lisberg/Inky-Impression-Weather-Station/enclosure/out/stand.step

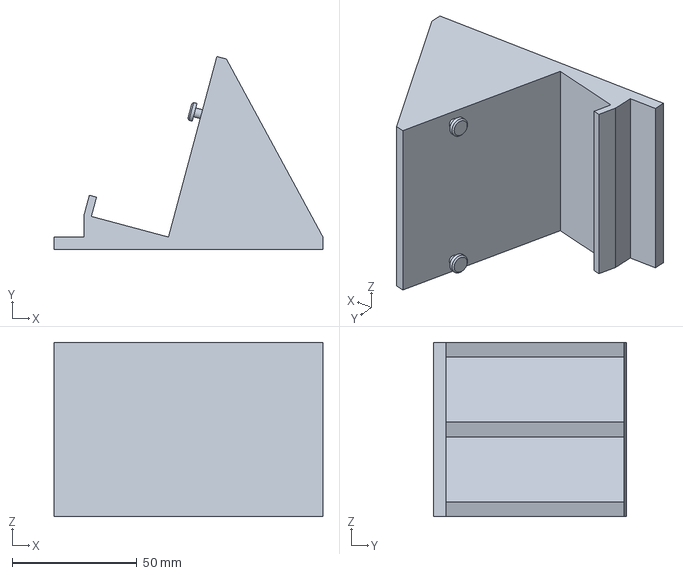
[picture p11: CAD file, 2026-11-04]
enclosure/out/stand.step
107.9 x 77.4 x 70.0 mm
