lisberg/Inky-Impression-Weather-Station/enclosure/out/back.step

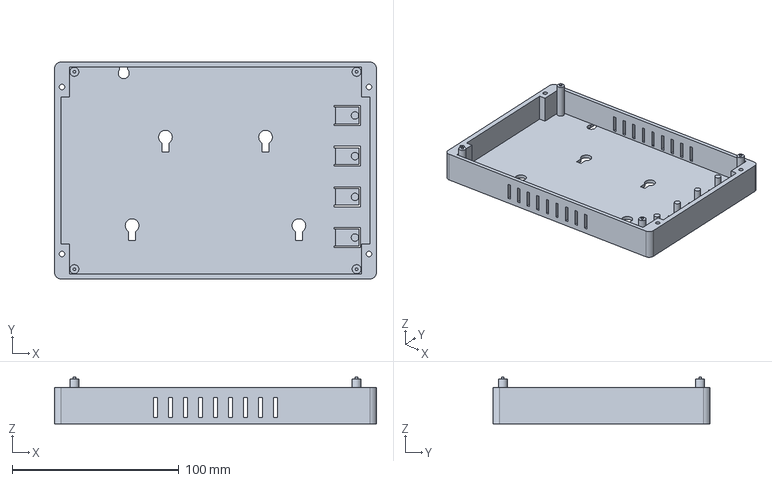
[picture p12: CAD file, 2026-11-04]
enclosure/out/back.step
193.0 x 130.1 x 28.2 mm
