lisberg/Inky-Impression-Weather-Station/enclosure/out/bezel.step

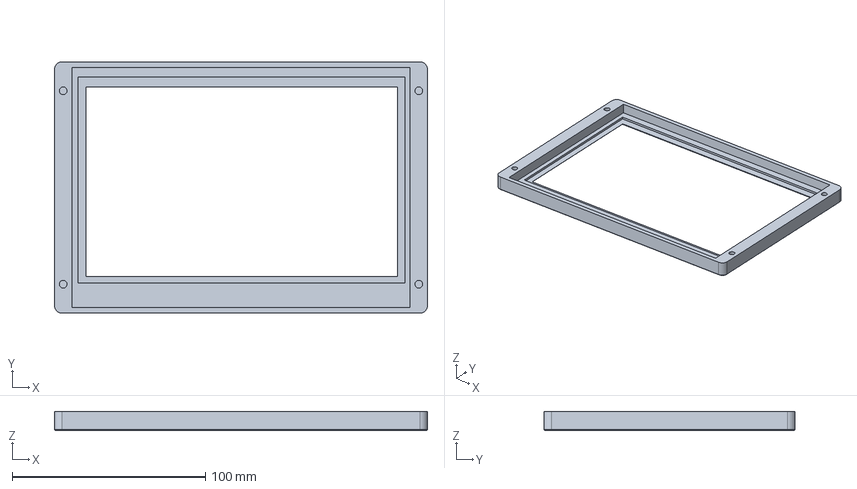
[picture p13: CAD file, 2026-11-04]
enclosure/out/bezel.step
193.0 x 130.1 x 10.0 mm
