lisberg/Inky-Impression-Weather-Station/enclosure/out/cable_hook.step

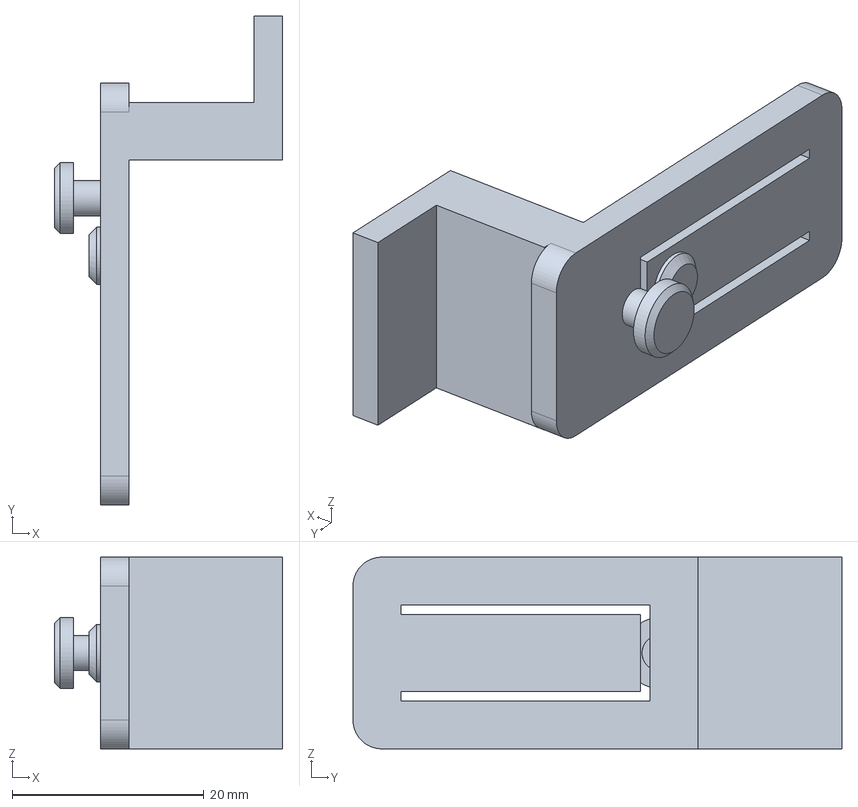
[picture p14: CAD file, 2026-11-04]
enclosure/out/cable_hook.step
23.8 x 51.0 x 20.0 mm
