lisberg/Inky-Impression-Weather-Station/(list of files, cad)

Other CAD files:
enclosure/out/back.3mf
enclosure/out/bezel.3mf
enclosure/out/cable_hook.3mf
enclosure/out/stand.3mf
