lisberg/Inky-Impression-Weather-Station/(commit log)

2026-10-19 Rework station: config file, Yr/SMHI providers, 800x480 layouts, night theme
    Replaces the OpenWeather scripts with a station package: JSON config with
    multiple locations, Yr and SMHI forecast providers with cached fetches,
    local sunrise/sunset, overview and week layouts for the 7.3" panel, and a
    night theme. Icons now come from the Weather Icons font so they scale and
    recolour cleanly.
    Claude-Session: https://claude.ai/code/session_01PSGzCCsaaUTuFZMPxqBwve
    [app.py, config.py, display.py, i18n.py, models.py]
2026-10-19 Buttons, info screen, WiFi fallback hotspot and deploy scripts
    A/B cycle locations, C cycles layout, D refreshes, holding D shows an info
    screen with WiFi, IP and Tailscale details. A netwatch service opens a setup
    hotspot when no saved network is reachable, and the screen shows how to join
    it. deploy/ holds an idempotent installer, Tailscale join, WiFi pre-loading
    and update scripts.
    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
2026-10-19 Fix setup hotspot URL constant; add pytest workflow
    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
    [netwatch.py]
2026-10-19 Parametric enclosure: bezel, back shell with flexure buttons, desk stand
    CadQuery model for the Inky Impression 7.3" with a Pi Zero 2 W behind it.
    The back shell clamps the board into the bezel, has flexure buttons over
    the board's rear buttons, keyholes for wall hanging and for the stand, vents
    and a USB slot. The script checks for collisions against a dummy board
    and on the stand before exporting STEP and 3MF.
    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
    [back.3mf, back.step, bezel.3mf, bezel.step, stand.3mf, stand.step]
2026-10-25 Run buttons on lgpio with a writable LG_WD; don't crash if GPIO fails
    gpiozero fell back to the sysfs pin factory (EINVAL on export) because lgpio
    could not create its notification pipes in the root-owned working directory.
    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
    [buttons.py]
2026-10-27 Dashboard redesign: card layout, tab bar on phones, light/dark theme, htmx
    - htmx (vendored, works offline on the setup hotspot) boosts every form, so
    changes save without full page reloads; everything still works without JS
    - the live panel preview leads the page, with quick place switching
    - segmented controls for layout and night mode; bottom tab bar on phones
    - System tab with status tiles and the station's recent log events
    - light and dark themes follow the system, with a toggle that overrides it
    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
    [app.py, web.py]
2026-11-02 Enclosure: use Linus's measured board and glass dimensions
    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
    [back.3mf, back.step, bezel.3mf, bezel.step, stand.3mf, stand.step]
2026-11-02 Enclosure: measured glass width and button spacing
    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
    [back.3mf, back.step, bezel.3mf, bezel.step, stand.3mf, stand.step]
2026-11-02 Enclosure: buttons 3.5 mm from the board edge; keep their tabs inside the pocket
    The tab slides inwards so its slot clears the side wall; the plunger stays
    over the switch, near the tab's free end. The fit check now fails if the
    plunger would fall off its tab.
    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
    [back.3mf, back.step, bezel.3mf, bezel.step, stand.3mf, stand.step]
2026-11-03 Enclosure: all board measurements in; fix front/back mirroring
    Adds the measured image area, corner holes (2.5 in, 2.0 mm), button height
    (5.4), Pi height (20) and the Pi's USB socket position, and trims the corner
    posts so they stay clear of the bezel wall.
    The model's +X points right seen from the back, but the glass, image-area
    and USB offsets were applied as if it pointed right seen from the front.
    Offsets given seen from the front are now mirrored into the model, and the
    buttons, given seen from the back, are used as they are.
    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
    [back.3mf, back.step, bezel.3mf, bezel.step, stand.3mf, stand.step]
2026-11-04 Enclosure: cable leaves through a notch in the back plate, clear of the stand
    The bottom-wall slot sat right on the stand's ledge, so the cable had
    nowhere to go on a desk. A keyhole notch at the back plate's bottom edge,
    55 mm off centre, lets it run straight out behind; the check now fails if
    the exit would end up behind the stand.
    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
    [back.3mf, back.step, bezel.3mf, bezel.step, stand.3mf, stand.step]
2026-11-04 Enclosure: larger cable notch (6.5 mm hole, 4.8 mm neck)
    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
    [back.3mf, back.step, bezel.3mf, bezel.step, stand.3mf, stand.step]
2026-11-04 Stand: cable winder posts behind the station
    The base runs on 32 mm past the ribs and carries two mushroom posts for
    winding up spare USB cable; a cone under each cap prints without supports.
    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
    [back.3mf, back.step, bezel.3mf, bezel.step, stand.3mf, stand.step]
2026-11-04 Enclosure: clip-in cable hooks for the wall keyholes instead of stand posts
    Each hook's peg locks at the top of an upper keyhole slot and a bump on a
    springy tongue drops into the entry hole, so it can't slide out. The hook
    is a side profile, printed on its side without supports. Fit checks cover
    the hooks against the back, the board and the stand.
    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
    [back.3mf, back.step, bezel.3mf, bezel.step, cable_hook.3mf, cable_hook.step, stand.3mf, stand.step]
2026-11-09 Display: fall back to the 7.3" Spectra 6 when the board's ID chip can't be read
    Linus's panel reports "No EEPROM detected", so the station only wrote a
    preview PNG. auto() failing now falls back to the E673 driver this project
    targets, and display.model in the config can name the panel outright
    (spectra73 or impressions73).
    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
    [app.py, config.py, display.py]
2026-11-09 Add an optional USB network link for the Pi Zero's data port
    deploy/usb-gadget.sh loads the g_ether gadget with fixed MAC addresses and
    gives usb0 a NetworkManager shared connection, so a laptop on the cable gets
    an address and reaches the station at 10.55.0.1 without any WiFi.
    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
